PurpleCactus2/Pet-Starbie/Assets/PCB Screenshots/PCB Render.png

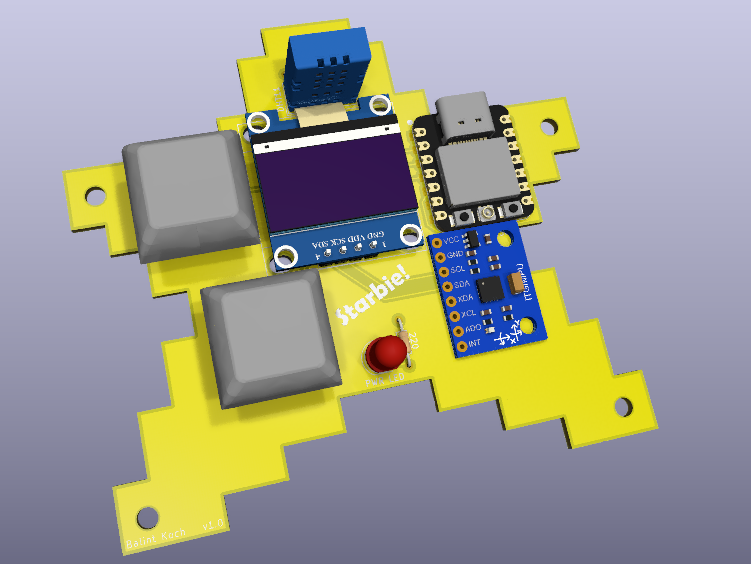
Assets/PCB Screenshots/PCB Render.png
