PurpleCactus2/Pet-Starbie/Assets/CAD Screenshots/Battery and Switch.png

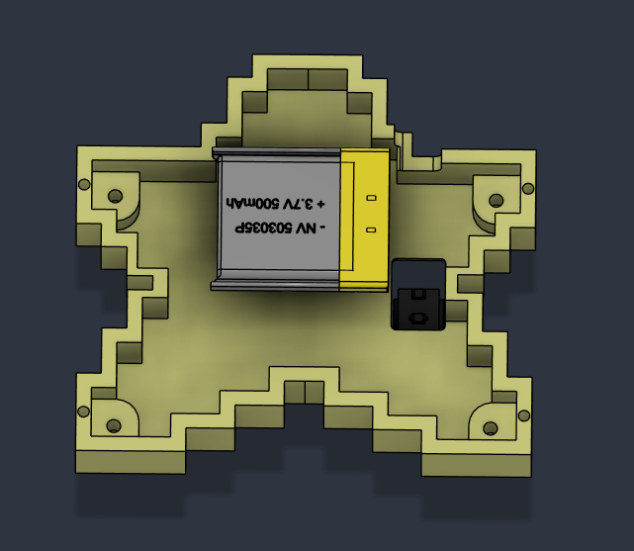
Assets/CAD Screenshots/Battery and Switch.png
