PurpleCactus2/Pet-Starbie/Assets/CAD Screenshots/Bottom CAD screenshot.png

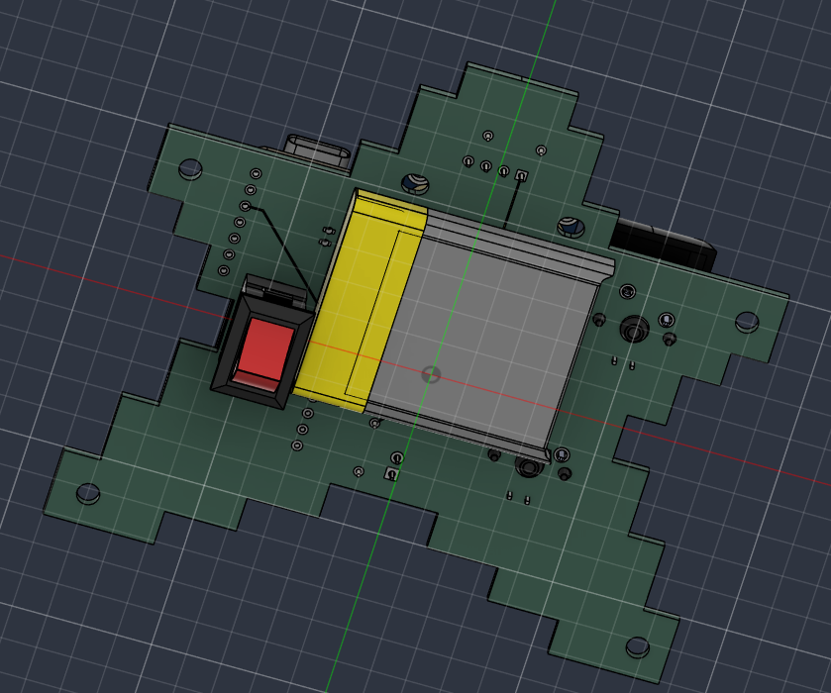
Assets/CAD Screenshots/Bottom CAD screenshot.png
