PurpleCactus2/Pet-Starbie/Assets/CAD Screenshots/CAD Screenshot.png

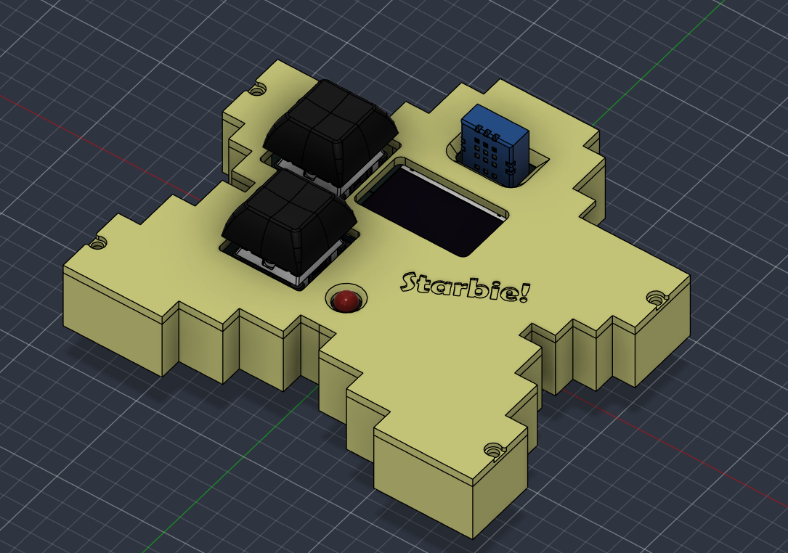
Assets/CAD Screenshots/CAD Screenshot.png
