PurpleCactus2/Pet-Starbie/Assets/CAD Screenshots/Exploded View.png

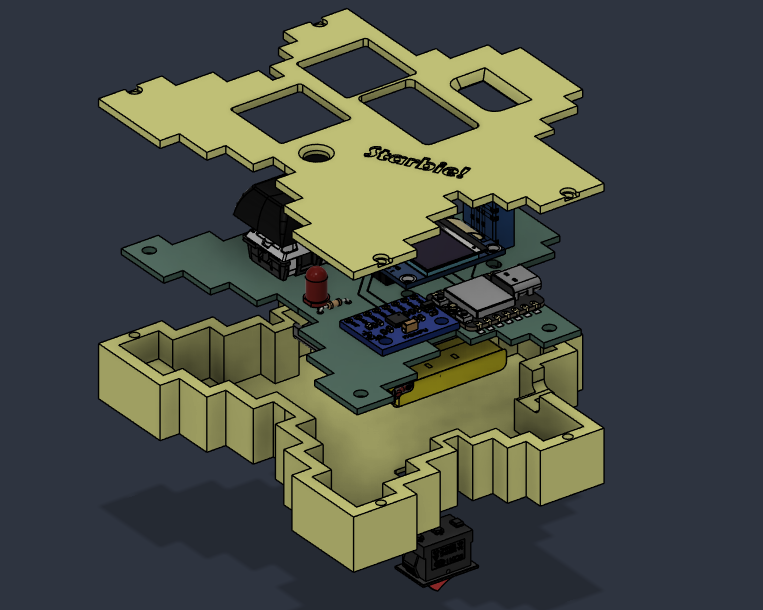
Assets/CAD Screenshots/Exploded View.png
