PurpleCactus2/Pet-Starbie/Assets/Cart Screenshots/Battery Payment.png

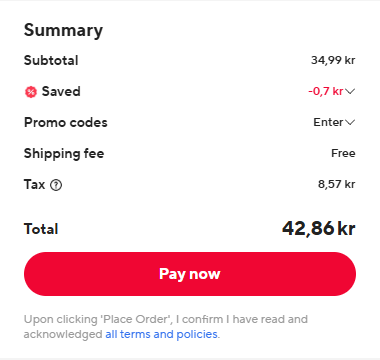
Assets/Cart Screenshots/Battery Payment.png
