PurpleCactus2/Pet-Starbie/Assets/Cart Screenshots/Battery Screenshot.png

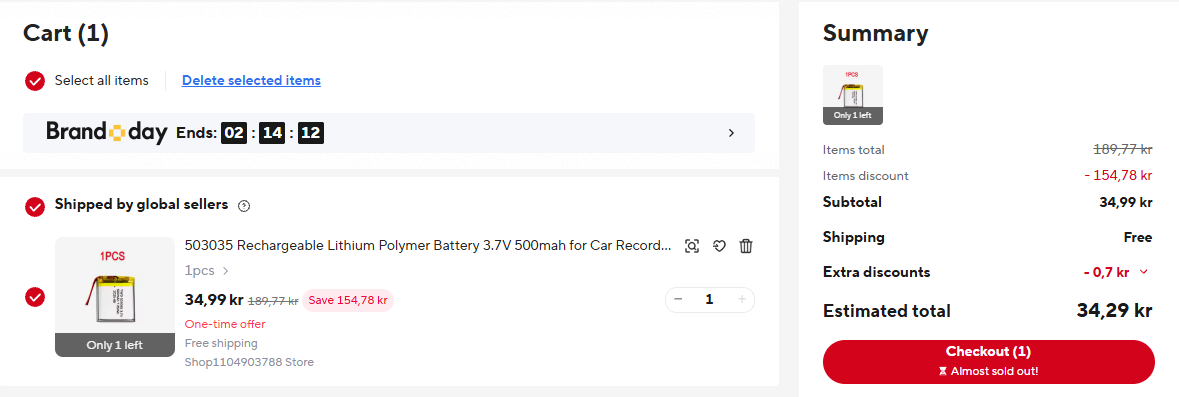
Assets/Cart Screenshots/Battery Screenshot.png
