PurpleCactus2/Pet-Starbie/Assets/Cart Screenshots/PCB Payment.png

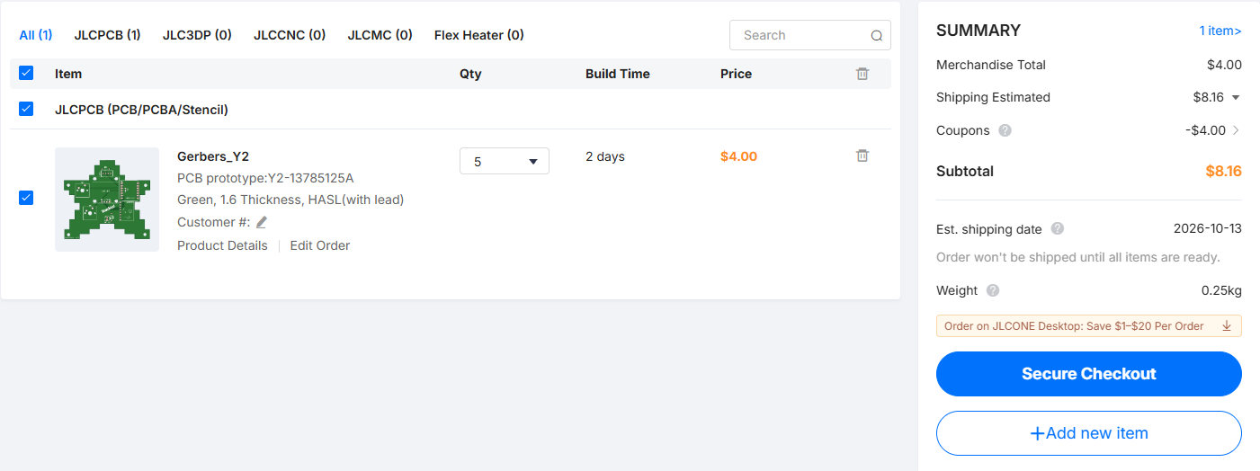
Assets/Cart Screenshots/PCB Payment.png
