PurpleCactus2/Pet-Starbie/Assets/PCB Screenshots/Battery Circuit.png

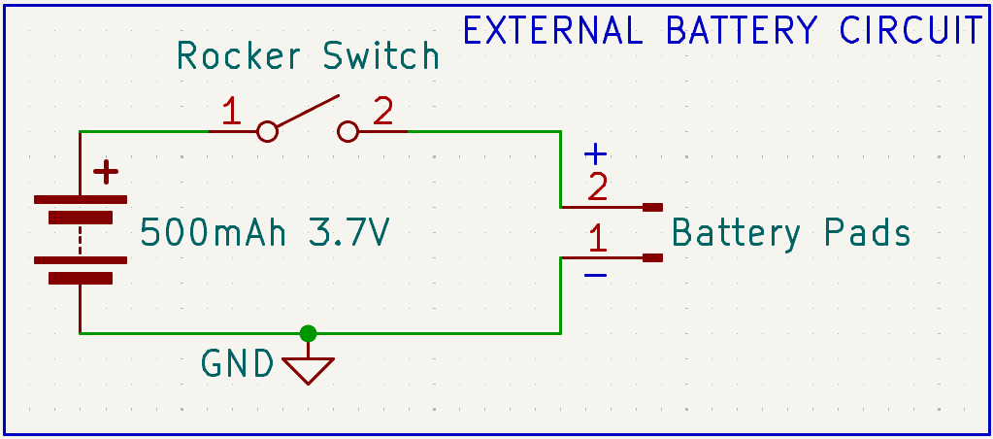
Assets/PCB Screenshots/Battery Circuit.png
