PurpleCactus2/Pet-Starbie/Assets/PCB Screenshots/Battery Pads PCB.png

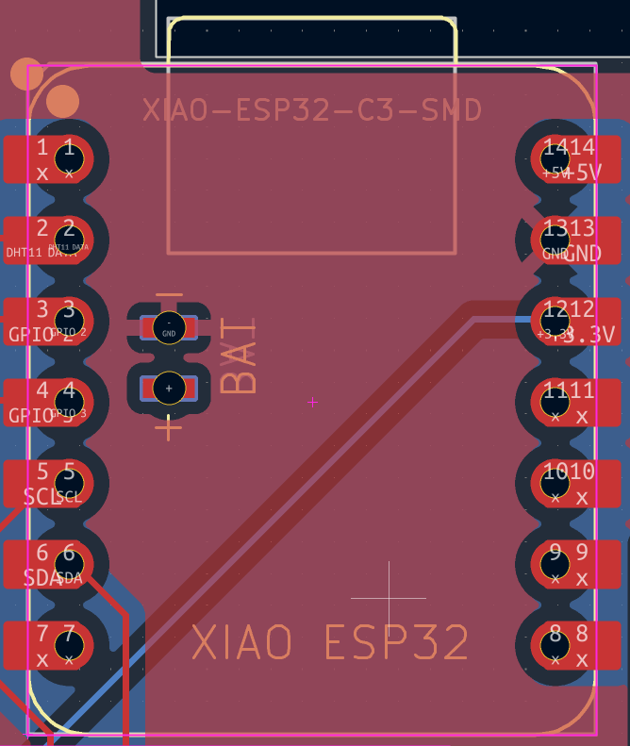
Assets/PCB Screenshots/Battery Pads PCB.png
