PurpleCactus2/Pet-Starbie/Assets/PCB Screenshots/PCB Screenshot.png

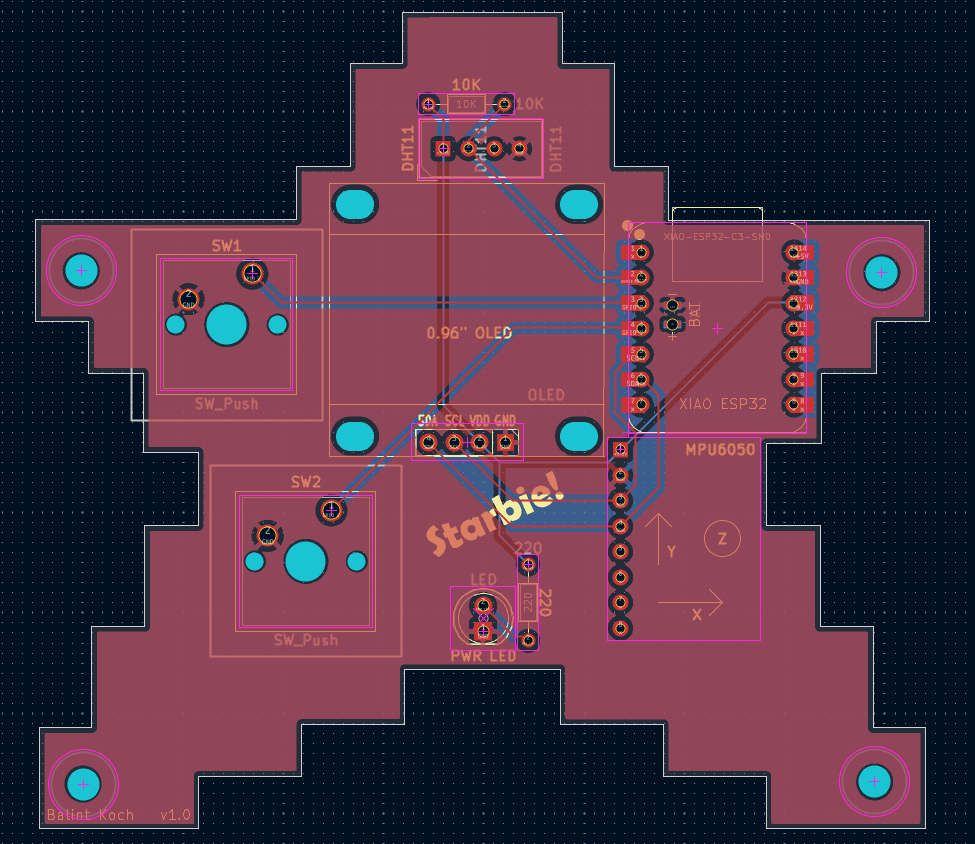
Assets/PCB Screenshots/PCB Screenshot.png
