PurpleCactus2/Pet-Starbie/Assets/PCB Screenshots/Power LED.png

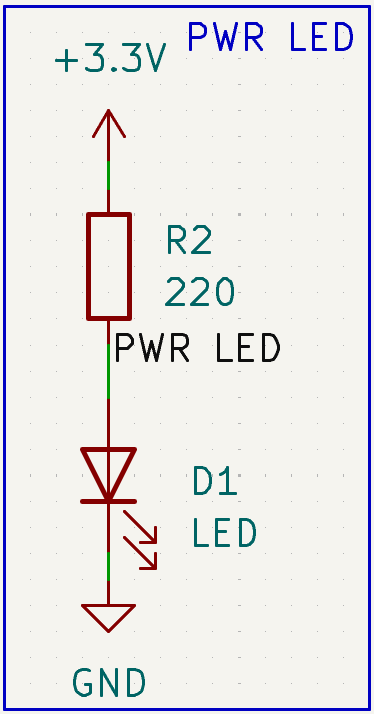
Assets/PCB Screenshots/Power LED.png
