PurpleCactus2/Pet-Starbie/Assets/PCB Screenshots/Schematic Screenshot.png

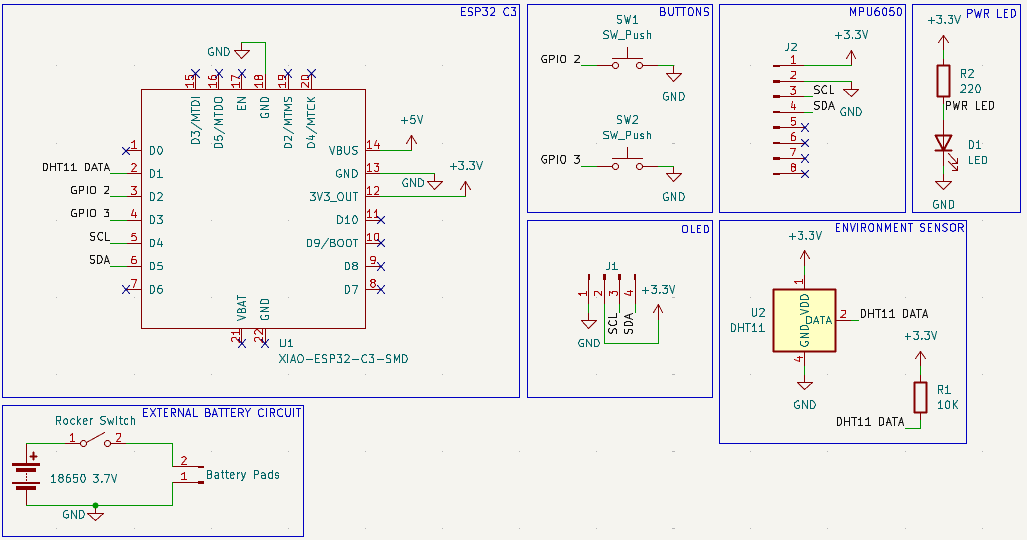
Assets/PCB Screenshots/Schematic Screenshot.png
