PurpleCactus2/Pet-Starbie/BOM.md

# Starbie – bill of materials

<!-- Generated by Half Life from project cmuv3dx1l0d4i01smq89bqj7a. Edits here are overwritten on the next sync. -->
<!-- Generated: 2026-10-11T19:30:48.984Z -->

> [!NOTE]
> This parts list is mirrored from [Half Life](https://halflife.hackclub.com). Editing it here will not change the platform's copy, and the next sync overwrites this file.

| Week | Tier | Parts funding |
| --- | --- | --- |
| Week 1 | Tier 1 | $30.00 |

| Part | What it's for | Qty | Unit | Total | Vendor |
| --- | --- | --- | --- | --- | --- |
| [XIAO ESP32 C3](https://www.aliexpress.com/item/1005008791937363.html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) | The main microcontroller | 1 | $8.84 | $8.84 | [AliExpress](https://www.aliexpress.com/item/1005008791937363.html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) |
| [0.96" OLED](https://www.aliexpress.com/item/1005006141235306.html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) | For displaying the sprite and actions | 1 | $2.31 | $2.31 | [AliExpress](https://www.aliexpress.com/item/1005006141235306.html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) |
| [MPU6050](https://www.aliexpress.com/item/1005010602044047.html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) | For calculating  orientation and acceleration | 1 | $2.10 | $2.10 | [AliExpress](https://www.aliexpress.com/item/1005010602044047.html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) |
| [DHT11](https://www.aliexpress.com/item/1005007728845619.html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) | For measuring temperature and humidity (Just the bare module, no breakout board) | 1 | $2.80 | $2.80 | [AliExpress](https://www.aliexpress.com/item/1005007728845619.html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) |
| [MX Switches](https://www.aliexpress.com/item/1005006376024657.html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) | Buttons to control different functions (Minimum order size: 10pcs) | 1 | $3.93 | $3.93 | [AliExpress](https://www.aliexpress.com/item/1005006376024657.html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) |
| [PCB](https://cart.jlcpcb.com/quote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) | Main Board (Use gerbers provided) | 1 | $4.00 | $4.00 | [JLCPCB](https://cart.jlcpcb.com/quote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) |
| [3.7V Battery](https://www.aliexpress.com/item/1005009736068698.html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) | Powering the device while not connected (Can be self funded) | 1 | $0.01 | $0.01 | [AliExpress](https://www.aliexpress.com/item/1005009736068698.html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) |
| [Passive Components](https://www.aliexpress.com/item/1005002489867848.html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) | (Resistors, LED, Switch) (Self provided) | 1 | $0.01 | $0.01 | [AliExpress](https://www.aliexpress.com/item/1005002489867848.html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) |
| [Screws](https://www.aliexpress.com/item/33043885403.html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) | For assembly of the enclosure, 4x self-tapping M3x8  and M2.5x8 (self provided) | 1 | $0.01 | $0.01 | [AliExpress](https://www.aliexpress.com/item/33043885403.html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) |
| **Parts subtotal** | — | — | — | **$24.01** | — |
| **Tax & shipping** | — | — | — | **$6.97** | — |
| **Total** | — | — | — | **$30.98** | — |

**$0.98 over the tier's funding.** Every tier gives a fixed amount for parts, so this needs cutting back or a higher tier.
