PurpleCactus2/Pet-Starbie/Assets/Cart Screenshots/Main Parts Payment.png

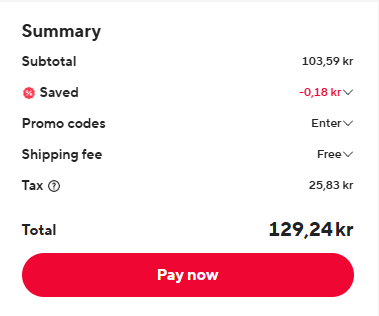
Assets/Cart Screenshots/Main Parts Payment.png
