PurpleCactus2/Pet-Starbie/Assets/Cart Screenshots/Main Parts Screenshot.png

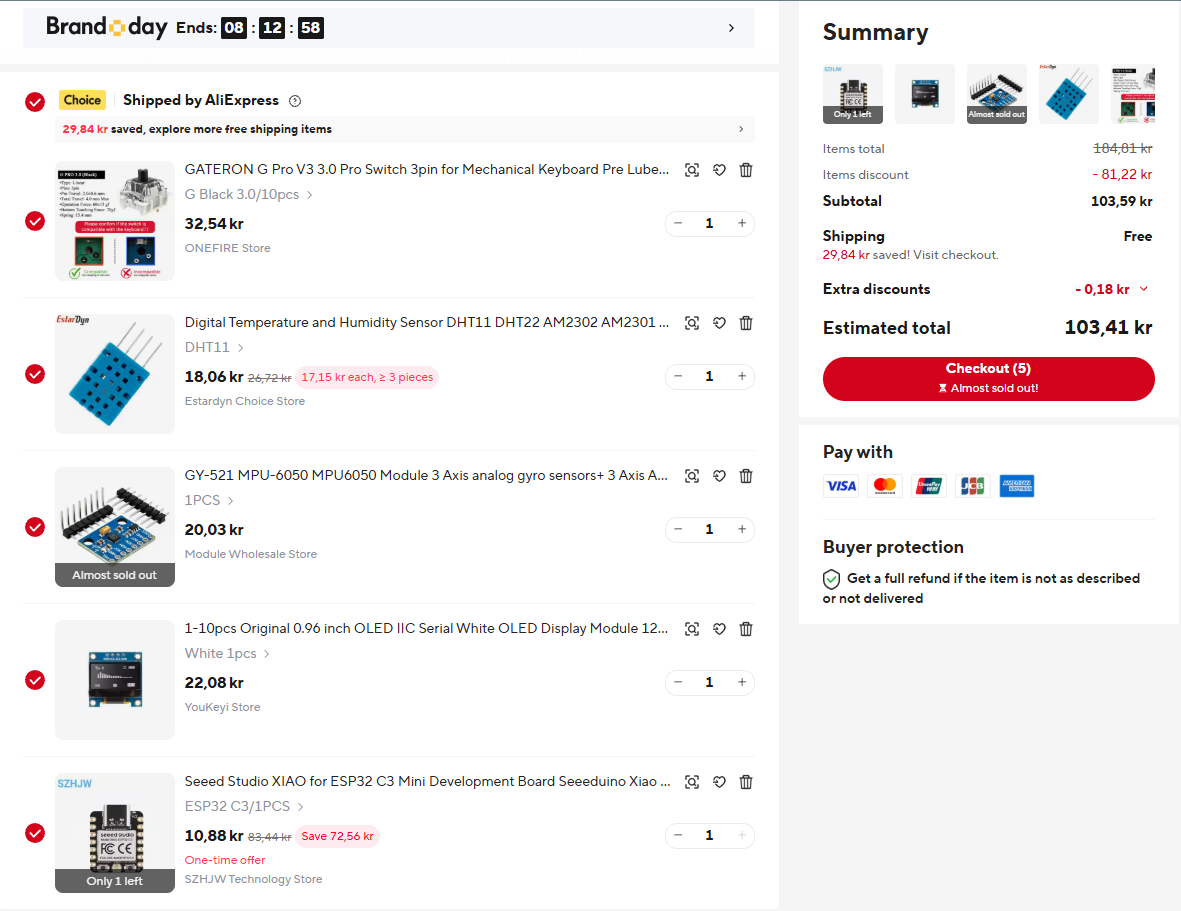
Assets/Cart Screenshots/Main Parts Screenshot.png
