PurpleCactus2/Pet-Starbie/CAD/Starbie.step

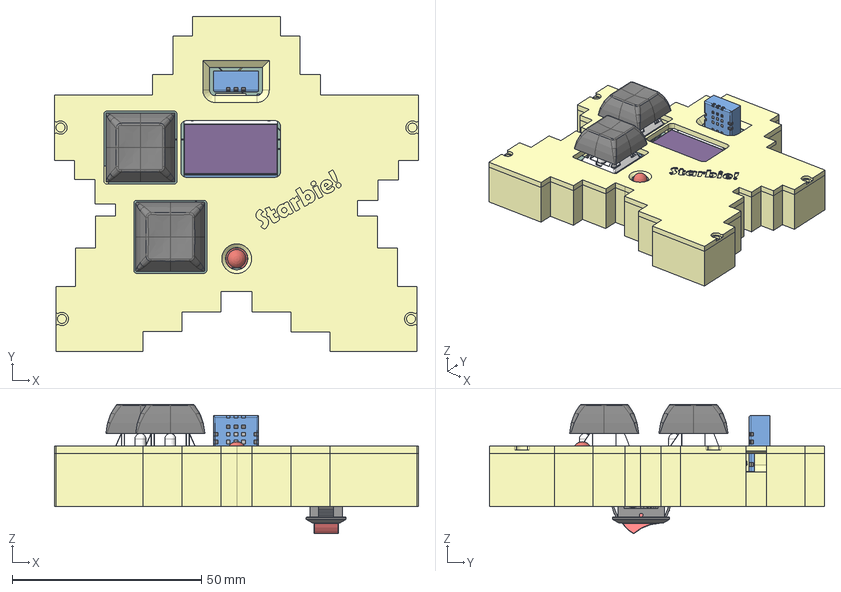
[picture p16: CAD file, 2026-10-11]
CAD/Starbie.step
96.3 x 88.7 x 34.2 mm
Bottom x 2
Pulsador x 2
Top x 2
Pieza5^Cherry MX x 2
Pin1 x 2
Pin2 x 2
Led 3mm_trans x 2
Keycap_adjusted v39 x 2
BOSS-EXTRUDE14_8_
BOSS-EXTRUDE7_4_
BOSS-EXTRUDE7_3_
BOSS-EXTRUDE14_4_
BOSS-EXTRUDE14_2_
BOSS-EXTRUDE14_11_
BOSS-EXTRUDE7_7_
BOSS-EXTRUDE14_9_
BOSS-EXTRUDE14_3_
BOSS-EXTRUDE14_7_
MIRROR2
BOSS-EXTRUDE14_5_
BOSS-EXTRUDE14_12_
BOSS-EXTRUDE7_8_
BOSS-EXTRUDE7_1_
BOSS-EXTRUDE14_10_
BOSS-EXTRUDE7_9_
BOSS-EXTRUDE14_6_
BOSS-EXTRUDE14_1_
BOSS-EXTRUDE7_6_
BOSS-EXTRUDE7_2_
CUT-EXTRUDE5
BOSS-EXTRUDE7_5_
U.FL Connector v1
Button (1) x 2
Shield
Aosong_DHT11_5.5x12.0_P2.54mm_1
R_Axial_DIN0204_L36mm_D16mm_P762mm_Horizontal x 2
PCB
trou1
trou002
trou003
trou004
trou005
trou006
trou007
trou008
Text_X
Symb_Y
Symb_X
Text_Y
Text_VCC
Text_GND
Text_SCL
Text_SDA
Text_XDA
Text_XCL
Text_ADO
Text_INT
R_0603_1608Metric
R_0603_1608Metric001
R_0603_1608Metric002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
