PurpleCactus2/Pet-Starbie/(list of files, cad)

Other CAD files:
CAD/Starbie.f3z
