PurpleCactus2/Pet-Starbie/JOURNAL.md

# Starbie – devlog

<!-- Generated by Half Life from project cmuv3dx1l0d4i01smq89bqj7a. Edits here are overwritten on the next sync. -->
<!-- Generated: 2026-10-11T18:39:50.584Z -->

> [!NOTE]
> This devlog is mirrored from [Half Life](https://halflife.hackclub.com). Editing it here will not change the platform's copy, and the next sync overwrites this file.

> A tiny motion-controlled digital pet, basically a desktop Tamagotchi. Totally not a Starboy.

| Week | Tier | Hours logged | Entries |
| --- | --- | --- | --- |
| Week 1 | Tier 1 | 17.68h | 10 |

## Contents

1. [2026-10-05 – Starting schematic](#2026-10-05-starting-schematic)
2. [2026-10-06 – Finishing the main schematic](#2026-10-06-finishing-the-main-schematic)
3. [2026-10-06 – Working on the PCB (almost done)](#2026-10-06-working-on-the-pcb-almost-done)
4. [2026-10-07 – Drawing the sprite](#2026-10-07-drawing-the-sprite)
5. [2026-10-08 – Adding the external battery circuit to the schematic](#2026-10-08-adding-the-external-battery-circuit-to-the-schema)
6. [2026-10-08 – Finalising the PCB and adding pads for the external battery](#2026-10-08-finalising-the-pcb-and-adding-pads-for-the-extern)
7. [2026-10-09 – Modelling the enclosure for the PCB and battery](#2026-10-09-modelling-the-enclosure-for-the-pcb-and-battery)
8. [2026-10-10 – Finishing up the CAD modelling: Added the switch and adjusted screw hole sizes](#2026-10-10-finishing-up-the-cad-modelling-added-the-switch-a)
9. [2026-10-10 – Looking for vendors, exporting PCB files, constructing the BOM, and also starting my README](#2026-10-10-looking-for-vendors-exporting-pcb-files-construct)
10. [2026-10-11 – Completely finishing the project: Finalising BOM, writing README, uploading all files and screenshots](#2026-10-11-completely-finishing-the-project-finalising-bom-w)

## Design

### 2026-10-05 – Starting schematic

**0.68h**

Starting schematic

[Timelapse](https://lookout.hackclub.com/api/media/5124fac8-8f27-4bac-8b43-9de2a06290ab/video.mp4)

### 2026-10-06 – Finishing the main schematic

**1h**

Finishing the main schematic

[Timelapse](https://lookout.hackclub.com/api/media/4f833298-d2eb-4d0a-9336-e219d8e7bda9/video.mp4)

### 2026-10-06 – Working on the PCB (almost done)

**2.78h**

Working on the PCB (almost done)

[Timelapse](https://lookout.hackclub.com/api/media/f058ea95-a168-4642-b2b1-bfae82114e59/video.mp4)

### 2026-10-07 – Drawing the sprite

**0.67h**

Drawing the sprite

[Timelapse](https://lookout.hackclub.com/api/media/67d8363e-8f7f-43d0-8e57-3f98272f5806/video.mp4)

### 2026-10-08 – Adding the external battery circuit to the schematic

**0.77h**

Adding the external battery circuit to the schematic

[Timelapse](https://lookout.hackclub.com/api/media/5b8e90ea-5774-41a7-8ac9-e3a1c404f22e/video.mp4)

### 2026-10-08 – Finalising the PCB and adding pads for the external battery

**1.87h**

Finalising the PCB and adding pads for the external battery

[Timelapse](https://lookout.hackclub.com/api/media/1d2513d3-6a69-44a8-a347-27950cfeb6b2/video.mp4)

### 2026-10-09 – Modelling the enclosure for the PCB and battery

**2.33h**

Modelling the enclosure for the PCB and battery

[Timelapse](https://lookout.hackclub.com/api/media/d63bb2bd-c46e-4459-97df-47303168b3e3/video.mp4)

### 2026-10-10 – Finishing up the CAD modelling: Added the switch and adjusted screw hole sizes

**1.02h**

Finishing up the CAD modelling: Added the switch and adjusted screw hole sizes

[Timelapse](https://lookout.hackclub.com/api/media/fb7a46ce-37af-43bb-a8d8-384d5e17a8eb/video.mp4)

### 2026-10-10 – Looking for vendors, exporting PCB files, constructing the BOM, and also starting my README

**2.48h**

Looking for vendors, exporting PCB files, constructing the BOM, and also starting my README

[Timelapse](https://lookout.hackclub.com/api/media/de65ad24-0adf-4842-9c18-9b2c66a07eba/video.mp4)

### 2026-10-11 – Completely finishing the project: Finalising BOM, writing README, uploading all files and screenshots

**4.08h**

Completely finishing the project: Finalising BOM, writing README, uploading all files and screenshots

[Timelapse](https://lookout.hackclub.com/api/media/3969db5f-146e-465b-b7e5-6ecf8c5e69e1/video.mp4)
