PurpleCactus2/Pet-Starbie/PCB/Starbie Schematic.pdf

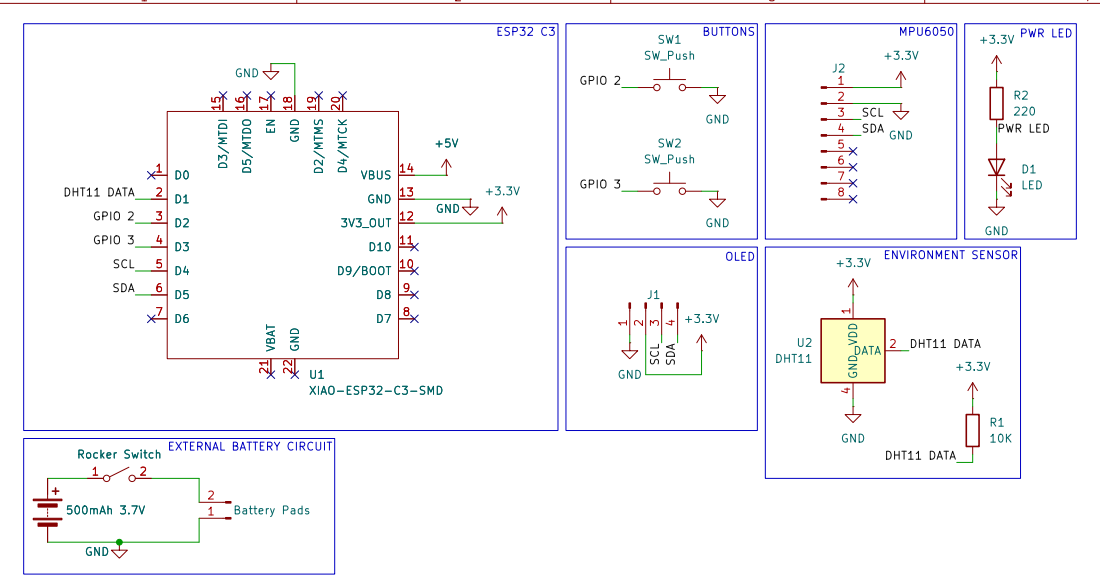
[picture p17: page 1]

Size: A4 | Rev: v1.0
KiCad E.D.A. 10.0.6 | Id: 1/1
