PurpleCactus2/Pet-Starbie/PCB/Starbie.kicad_pcb

## KiCad design PCB/Starbie.kicad_pcb (2026-10-11)

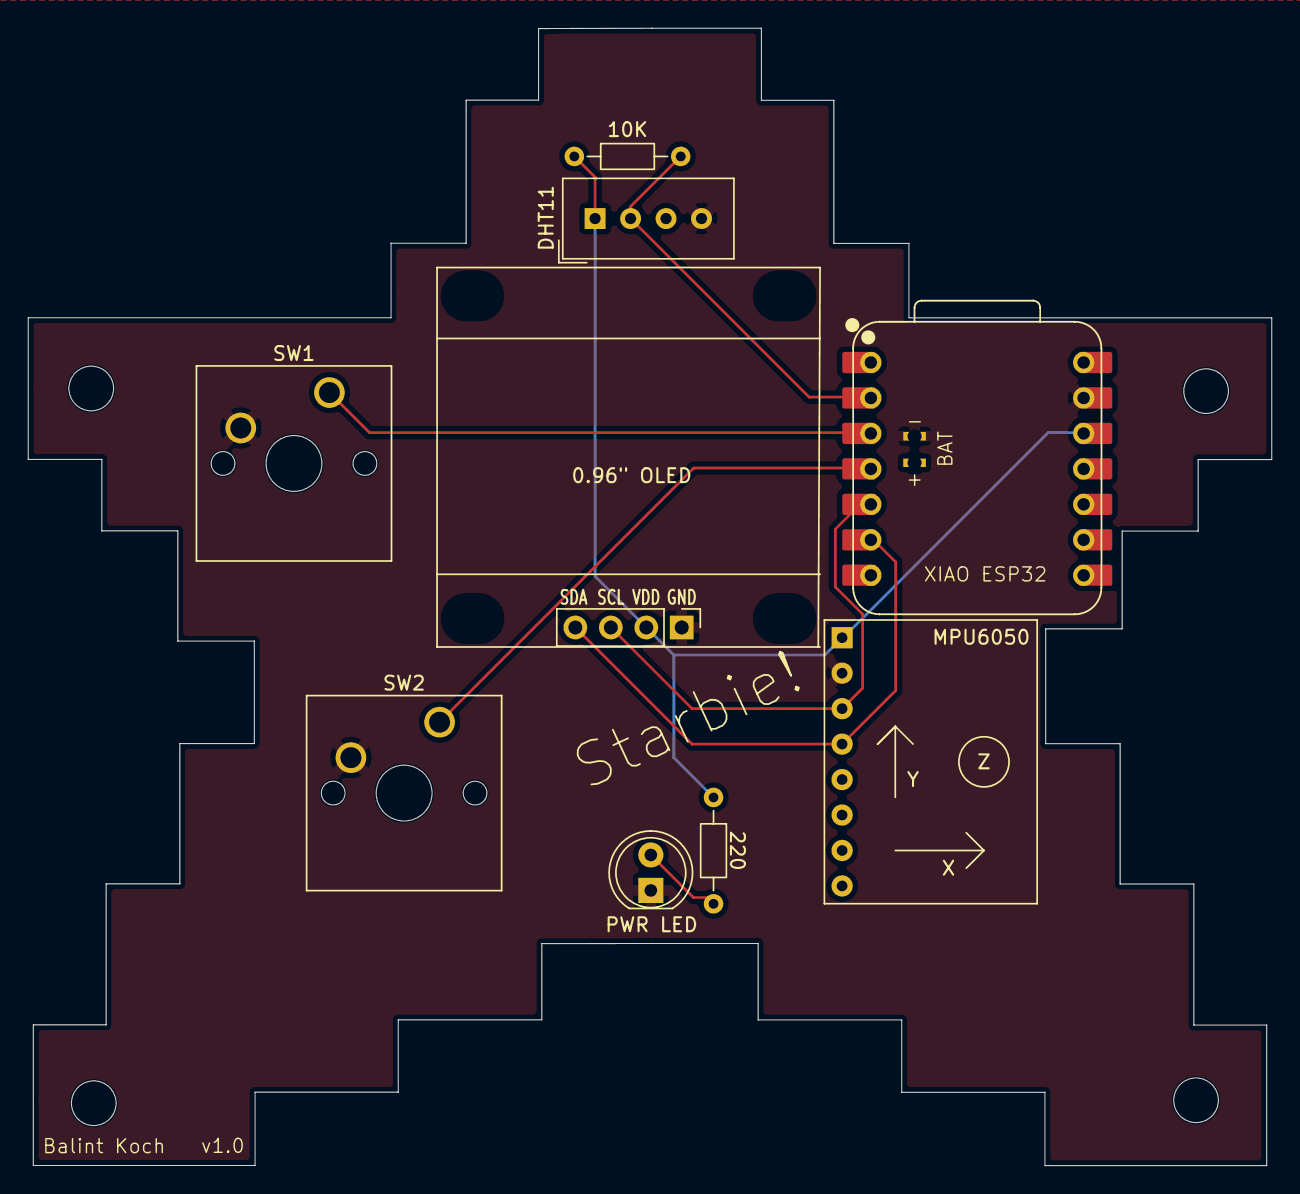
[picture p18: board Starbie.kicad_pcb from above]

Board: 2 copper layers, 89.1 x 81.5 mm, 10 parts (0 on the bottom side), 8 nets.

Parts:
0.96" OLED: OLED; Display_128x64_096_I2C
10K: 10K; R_Axial_DIN0204_L3.6mm_D1.6mm_P7.62mm_Horizontal
220: 220; R_Axial_DIN0204_L3.6mm_D1.6mm_P7.62mm_Horizontal
DHT11: DHT11; Aosong_DHT11_5.5x12.0_P2.54mm
J3: Battery Pads; XIAO-ESP32-BATTCONTACTS
MPU6050: MPU6050; MPU6050_Module
PWR LED: LED; LED_D5.0mm
SW1, SW2: SW_Push; SW_Cherry_MX_1.00u_PCB
U1: XIAO-ESP32-C3-SMD; XIAO-ESP32-C6-DIP

Connections:
+3.3V: 0.96" OLED.2, 10K.1, 220.1, DHT11.1 (VDD), MPU6050.1, U1.12 (3V3_OUT)
/DHT11 DATA: 10K.2, DHT11.2 (DATA), U1.2 (D1)
/GPIO 2: SW1.1, U1.3 (D2)
/GPIO 3: SW2.1, U1.4 (D3)
/PWR LED: 220.2, PWR LED.2 (A)
/SCL: 0.96" OLED.3, MPU6050.3, U1.5 (D4)
/SDA: 0.96" OLED.4, MPU6050.4, U1.6 (D5)
GND: 0.96" OLED.1, DHT11.4 (GND), J3.-, MPU6050.2, PWR LED.1 (K), SW1.2, SW2.2, U1.13 (GND)
