PurpleCactus2/Pet-Starbie/(commit log)

2026-10-10 Expand README with project details and sections
    Added sections for introduction, PCB, code, enclosure, and BOM to README.
2026-10-11 Update README with BOM and funding details
    Added detailed BOM with component links, prices, and notes on funding.
2026-10-11 Enhance README with project details and features
    Expanded the README to provide detailed information about the Pet-Starbie project, including its features, PCB and schematic details, code modifications, enclosure design, and BOM.
2026-10-11 Revise component details and update total cost
    Updated battery and passive components entries with additional notes and corrected total cost.
2026-10-11 Revise BOM with discounted prices and funding notes
    Updated the BOM section with expected discounted prices and clarified self-funded components.
